UNIT-Electronics/Evasor-de-Obst-culos-Kit/README.md

# Kit Evasor de Obstaculos - Unit Electronics

SKU

El **Kit de Robot Evasor de Obstáculos** es ideal para comenzar en el mundo de la robótica de una manera sencilla y, posteriormente, puedas construir prototipos de mayor complejidad.
El Robot Evasor de Obstáculos tiene como objetivo avanzar en línea recta, si detecta un obstáculo girará sobre su eje hasta esquivar el objeto y continuar con su ruta de línea recta.

Se proporciona información útil para el armado de este robot con el siguiente contenido: 
* [Identificación de material](https://github.com/UNIT-Electronics/Evasor-de-Obstaculos-Kit/blob/main/Material%20Workshop.pdf)
* [Guía de ensamble](https://github.com/UNIT-Electronics/Evasor-de-Obstaculos-Kit/blob/main/Diagrama%20de%20Armado%20Workshop.pdf)
* [Guía de conexiones](https://github.com/UNIT-Electronics/Evasor-de-Obstaculos-Kit/blob/main/DIAGRAMA%20DE%20CONEXI%C3%93N.pdf)
* [Código en Arduino IDE](https://github.com/UNIT-Electronics/Evasor-de-Obstaculos-Kit/blob/main/Robot-Evasor-Obstaculos-2024.ino)

3D
