UNIT-Electronics/Evasor-de-Obst-culos-Kit/Material Workshop.pdf

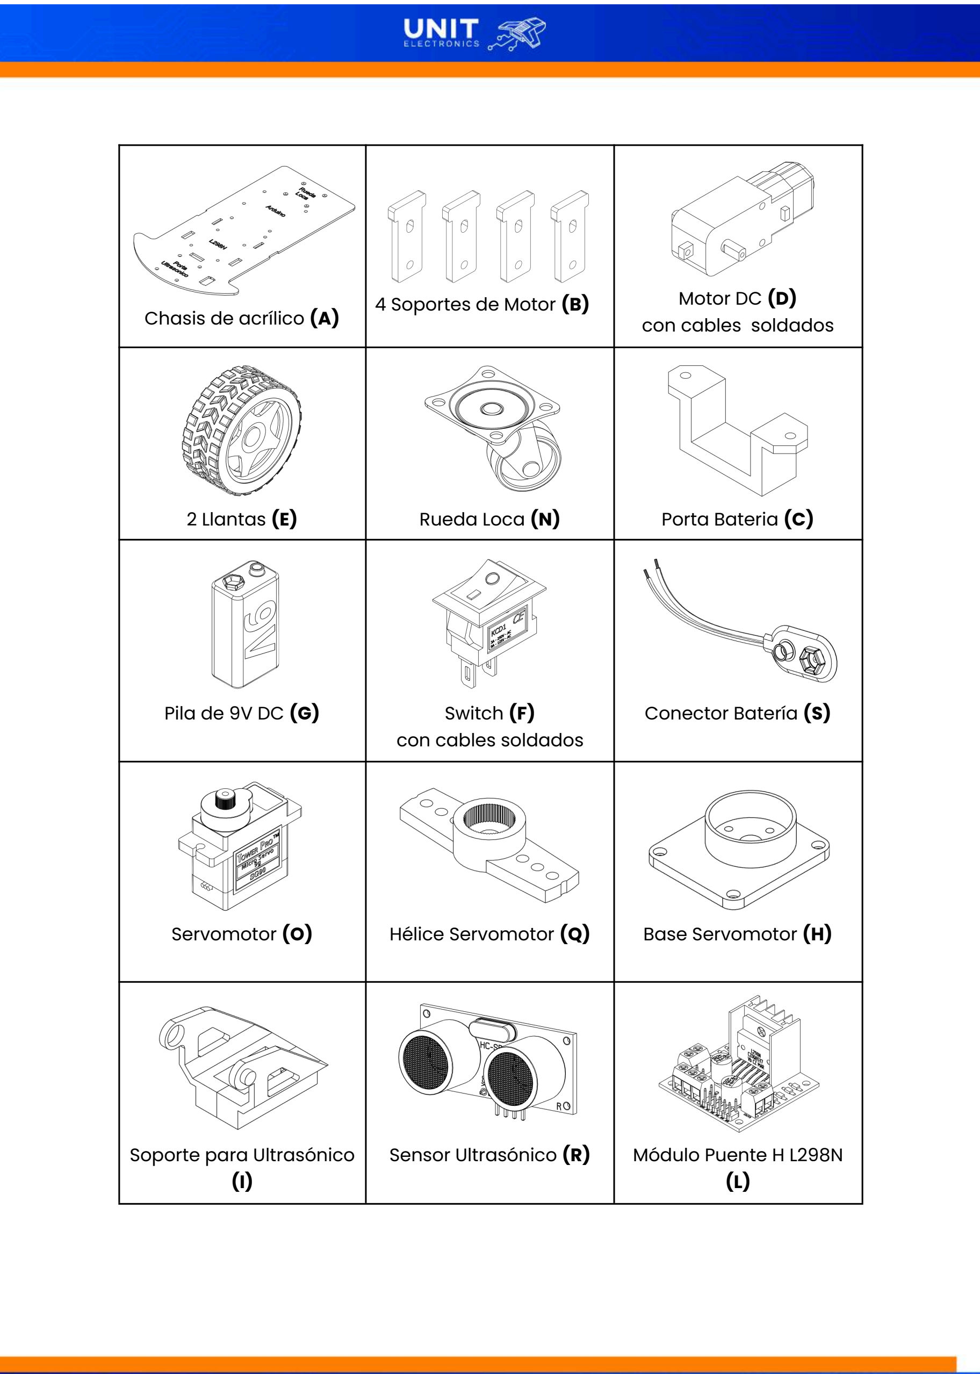
[picture p4: page 1]

Chasis de acrílico (A) | 4 Soportes de Motor (B) | Motor DC (D) con cables soldados
2 Llantas (E) | Rueda Loca (N) | Porta Bateria (C)
Pila de 9V DC (G) | Switch (F) con cables soldados | Conector Batería (S)
Servomotor (O) | Hélice Servomotor (Q) | Base Servomotor (H)
Soporte para Ultrasónico (I) | Sensor Ultrasónico (R) | Módulo Puente H L298N (L)

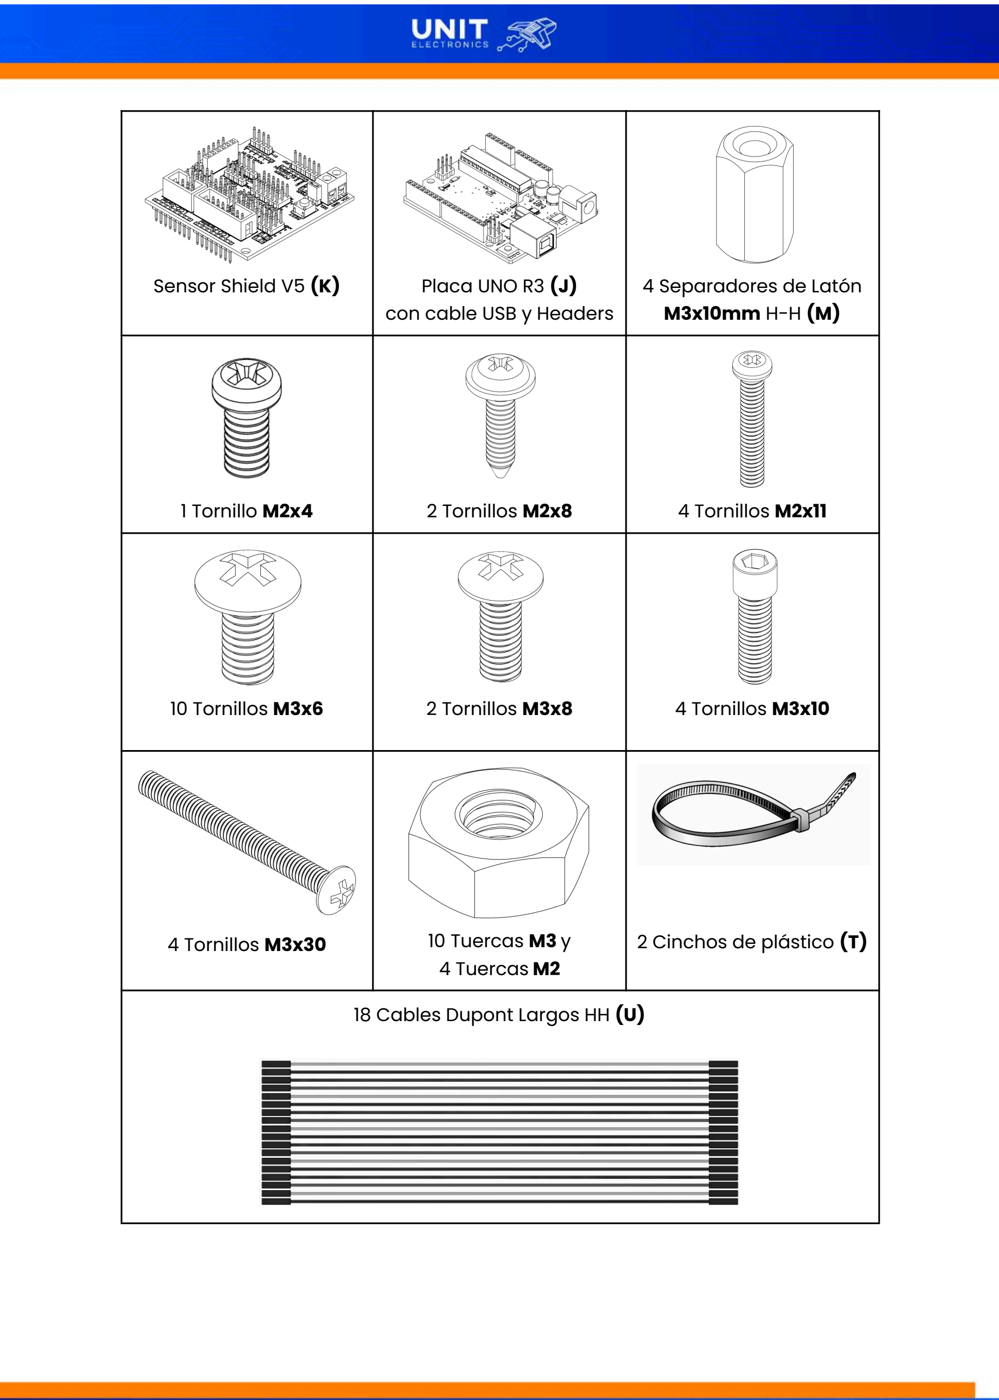
[picture p5: page 2]

Sensor Shield V5 (K) | Placa UNO R3 (J) con cable USB y Headers | 4 Separadores de Latón M3x10mm H-H (M)
1 Tornillo M2x4 | 2 Tornillos M2x8 | 4 Tornillos M2x11
10 Tornillos M3x6 | 2 Tornillos M3x8 | 4 Tornillos M3x10
4 Tornillos M3x30 | 10 Tuercas M3 y 4 Tuercas M2 | 2 Cinchos de plástico (T)

18 Cables Dupont Largos HH (U)
